eatoin5hrdlu/pumphouse/AfriDev Spout.png

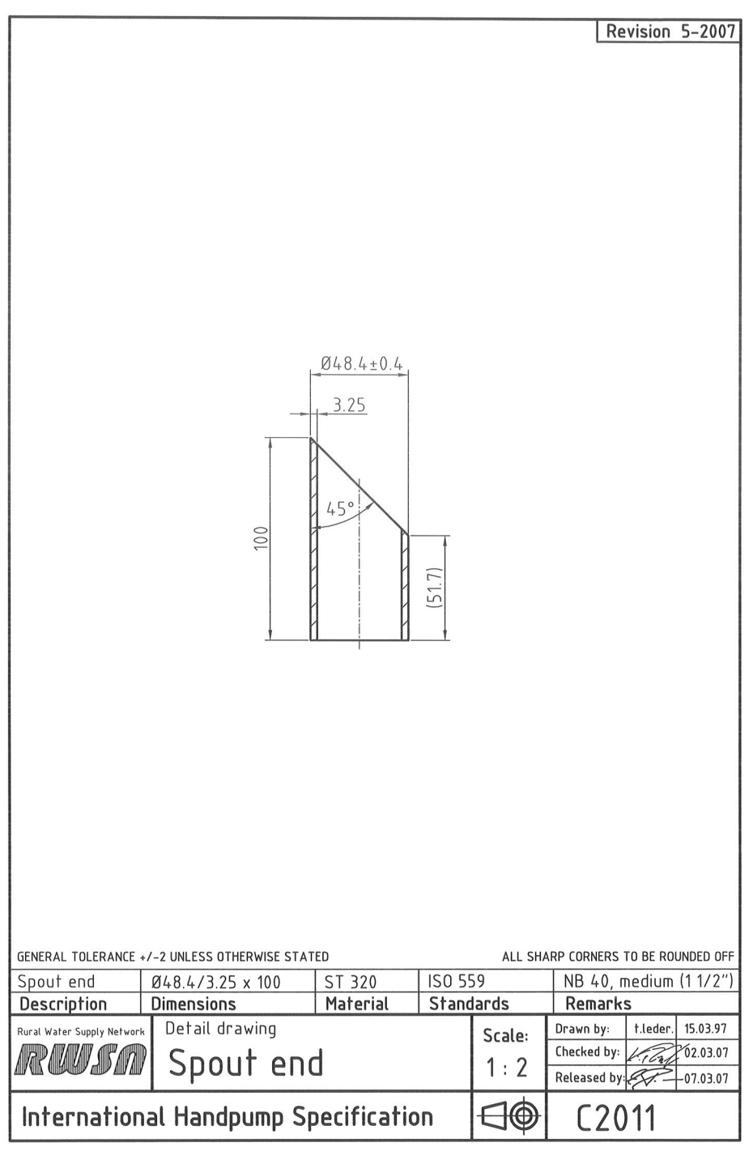
AfriDev Spout.png
