eatoin5hrdlu/pumphouse/connections.png

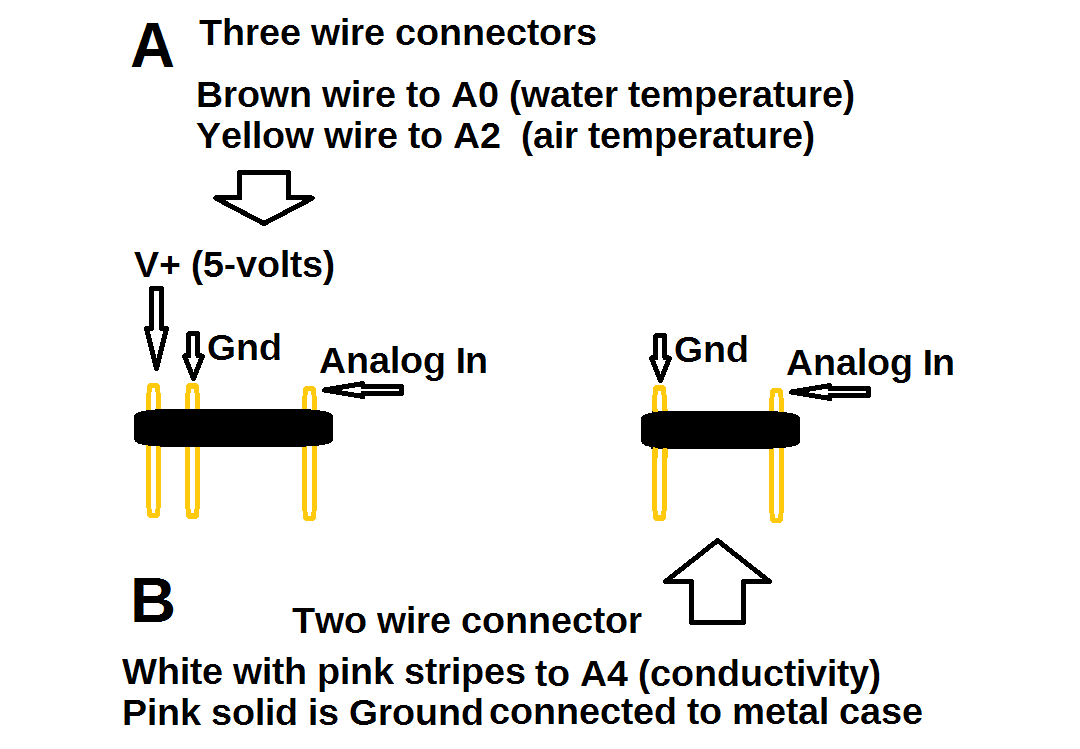
connections.png
