eatoin5hrdlu/pumphouse/pipeattach.png

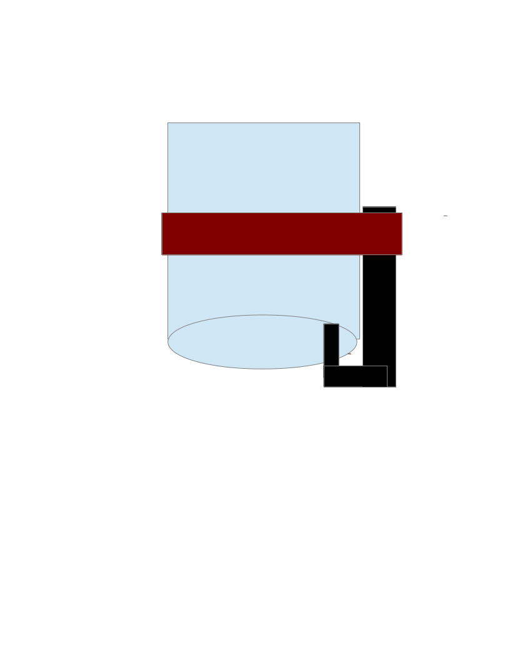
pipeattach.png
