eatoin5hrdlu/pumphouse/temperature sensor stainless tubing.jpg

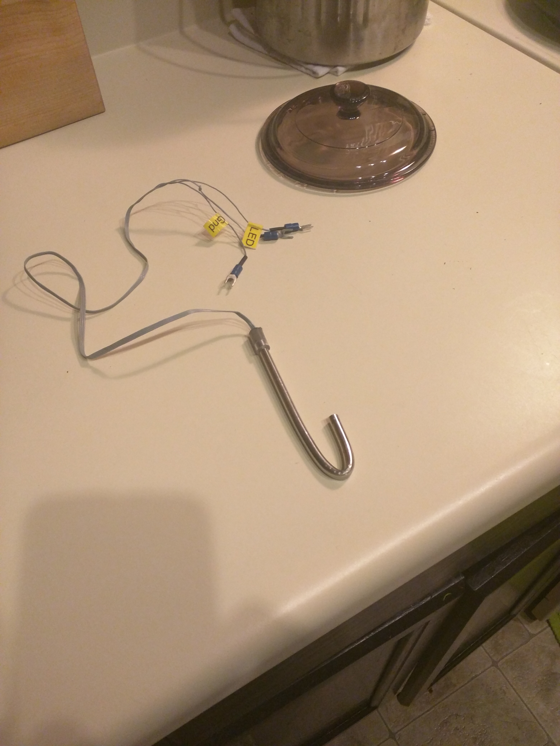
temperature sensor stainless tubing.jpg
