eatoin5hrdlu/pumphouse/top.jpg

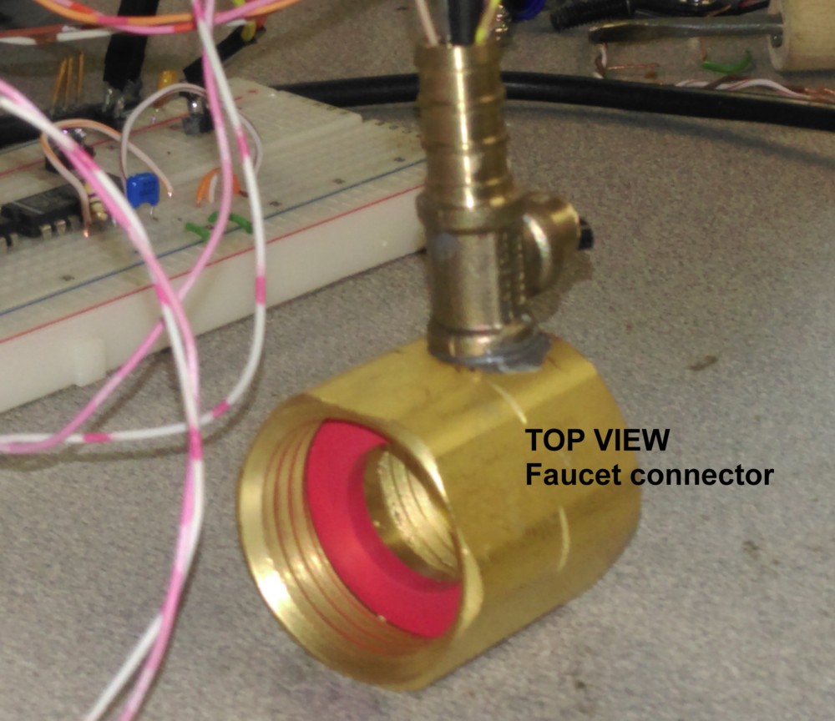
top.jpg
