eatoin5hrdlu/pumphouse/wye-brass-hose-fitting.jpg

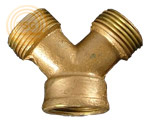
wye-brass-hose-fitting.jpg
