eatoin5hrdlu/pumphouse/(commit log)

2016-08-30 new pullup/pulldown values for conductivity sensor tried
2016-08-31 pipe frame
2016-08-31 Added arduino code for button press and sms send
2016-08-31 added device picture to README.md
